MackPI/UProgrammer-Hardware/README.md

# UProgrammer-Hardware
Kicad Files for Universal programmer

Version J has updates for another spin of the PCB. 
Found errors and fixed them while checking the plots.
