MackPI/UProgrammer-Hardware/Programmer.ods

Id | Designator | Package | Quantity | Designation | Supplier and ref | Extended price @ Q5
2 | BT1 | PINHEAD1-2 | 1 | BATTERY | N/A (Will use scrap wires and Power supply)
3 | C1,C2,C12 | C_1206_HandSoldering | 3 | 1 µF | Digikey | $1.56
12 | C11,C14 | C_1206_HandSoldering | 2 | 2.2 µF 25V | Digikey | $1.53
4 | C3 | C_1206_HandSoldering | 1 | 4.7 µF | Digikey | $1.00
1 | C4,C5,C6,C7,C8,C9,C10,C13,C15,C16 | C_1206_HandSoldering | 10 | 0.1 µF | Digikey | $1.48
5 | CON1 | USB_Micro-B | 1 | USB_OTG | Digikey | $2.30
16 | D1 | MiniMELF_Handsoldering | 1 | SD103AWS | Digikey | $1.75
17 | L1 | Choke_SMD_1206_Handsoldering | 1 | 2.2 µH | Digikey | $1.90
11 | M1 | ESP-12E | 1 | ESP-12E | Banggood | $18.00 | Already purchased
18 | P1 | Measurement_Point_Square-TH_Big | 1 | Test | N/A
6 | P3 | Pin_Header_Straight_2x06 | 1 | CONN_12 | Digikey | $1.35
29 | Q1,Q3 | SOT-23 | 2 | MMBT3904 | Digikey | $0.95
30 | Q2 | SOT-23 | 1 | MMBT3906 | Digikey | $0.60
7 | R1,R2,R3,R4,R11,R12,R13 | R_1206_HandSoldering | 7 | 10K | Digikey | $0.62
24 | R14 | R_1206_HandSoldering | 1 | 100K | Digikey | $0.32 | Extra
25 | R15,R16 | R_1206_HandSoldering | 2 | 1M | Digikey | $0.24
19 | R5 | R_1206_HandSoldering | 1 | 24K | Digikey | $0.24 | Extra
20 | R6 | R_1206_HandSoldering | 1 | 47K | Digikey | $0.24
21 | R7,R10 | R_1206_HandSoldering | 2 | 4.7K | Digikey | $0.77
22 | R8 | R_1206_HandSoldering | 1 | 58.2K | Digikey | $0.32 | Extra (58.2K)
23 | R9 | R_1206_HandSoldering | 1 | 4.99K | Digikey | $0.32 | Extra
32 | REF**,REF**,REF**,REF** | MountingHole_3mm | 4 | MountingHole_3mm | N/A
14 | SW1 | SW_SPST_PTS645 | 1 | Upload | Digikey | $2.39
15 | SW2 | SW_SPST_PTS645 | 1 | RESET | ^^^ | ^^^ | Included in line above
8 | U1 | SOT-23-5 | 1 | AP2112K-3.3 | Digikey | $2.80
28 | U10 | SC-70-6_Handsoldering | 1 | NC7SB3157 | Digikey | $2.05
9 | U2 | SOIC-8_3.9x4.9mm_Pitch1.27mm | 1 | 23LC1024 | Digikey | $12.60
10 | U3,U4,U5,U6 | MSOP-8_3x3mm_Pitch0.65mm | 4 | 74LVC2T45 | Digikey | $11.50
31 | U7 | 12-TFSOJ | 1 | AAT1230 | Digikey | $3.40
26 | U8 | QFN-24-1EP_4x4mm_Pitch0.5mm | 1 | CP2104 | Digikey | $9.00
27 | U9 | SOIC-18_7.5x11.6mm_Pitch1.27mm | 1 | MCP23S08 | Digikey | $6.40
 | PCB |  |  |  | OSHPark | $60.00 | 6 PCBs
 |  |  |  |  |  | $145.63
 |  |  |  |  | Price/piece | $29.13
