MackPI/UProgrammer-Hardware/Programmer.kicad_pcb

## KiCad design Programmer.kicad_pcb (2016-11-04)

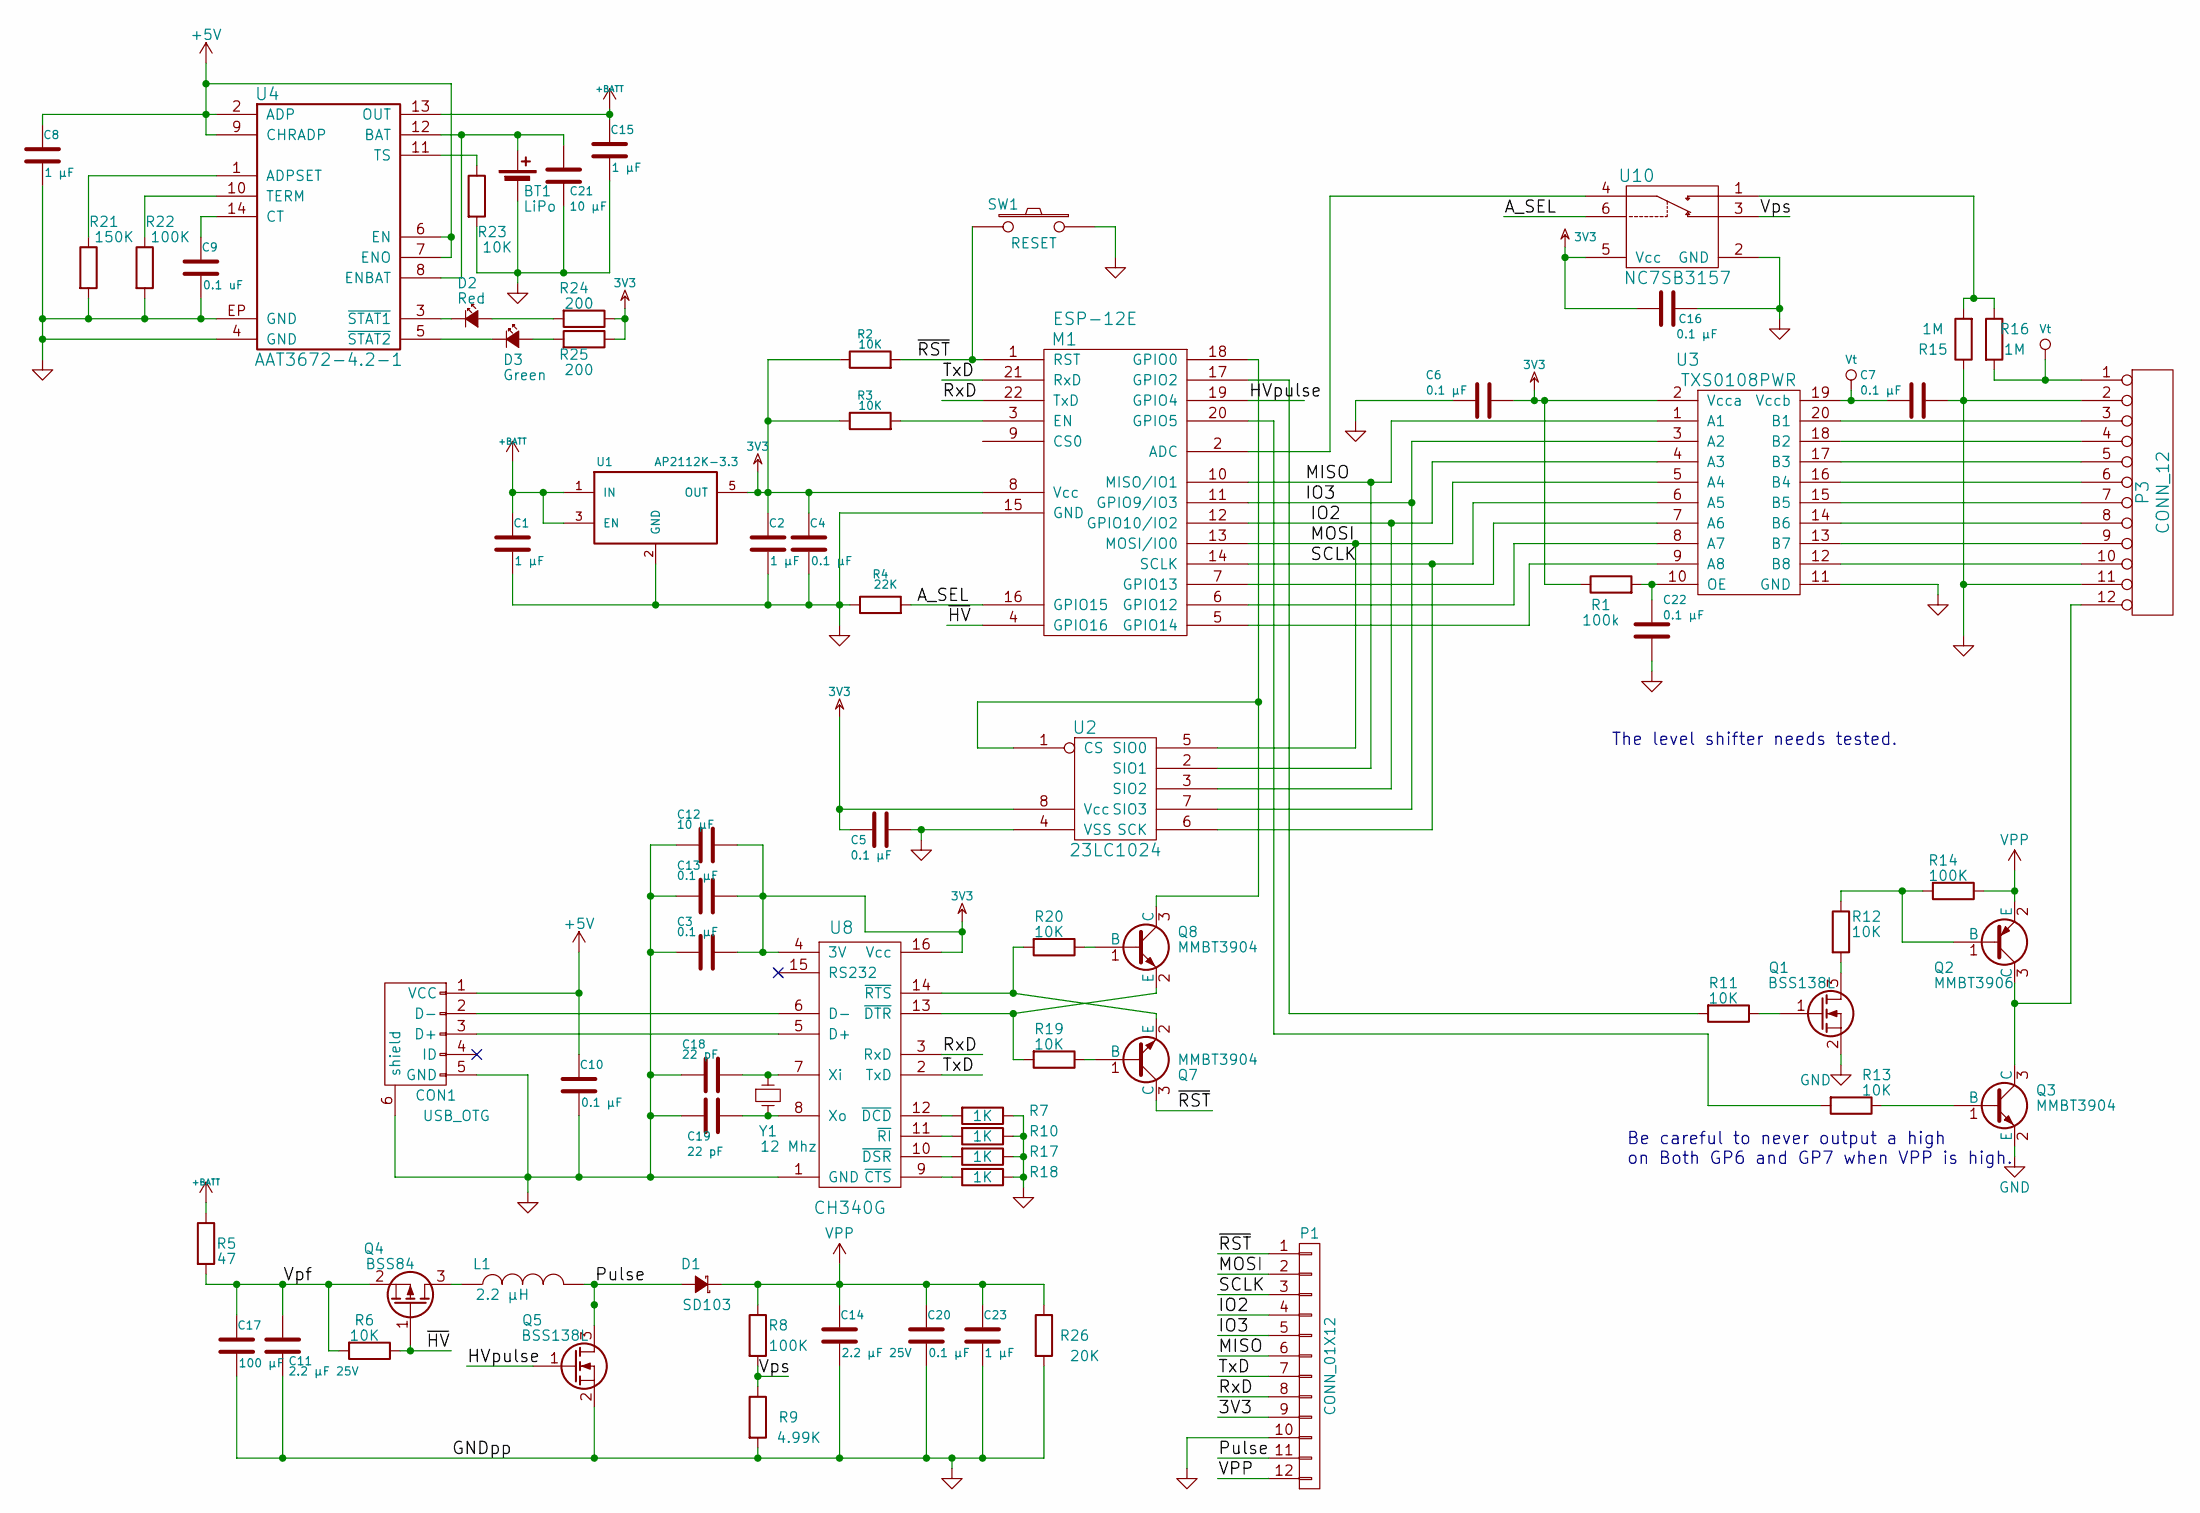
[picture p1: schematic Programmer.sch]

Parts:
BT1: LiPo; PINHEAD1-2
C1, C2, C8, C15, C23: 1 µF; C_1206
C3, C4, C5, C6, C7, C10, C13, C16, C20, C22: 0.1 µF; C_1206
C9: 0.1 uF; C_1206
C11, C14: 2.2 µF 25V; C_1206
C12, C21: 10 µF; C_1206
C17: 100 µF; C_1206
C18, C19: 22 pF; C_1206
CON1: USB_OTG; USB_Micro-B
D1: SD103; SOD-323
D2: Red; LED_1206
D3: Green; LED_1206
L1: 2.2 µH; Choke_SMD_1206_Standard
M1: ESP-12E
P1: CONN_01X12; Socket_Strip_Straight_1x12
P3: CONN_12; Pin_Header_Straight_2x06
Q1, Q5: BSS138L; SOT-23
Q2: MMBT3906; SOT-23
Q3, Q7, Q8: MMBT3904; SOT-23
Q4: BSS84; SOT-23
R1: 100k; R_1206
R2, R3, R6, R11, R12, R13, R19, R20, R23: 10K; R_1206
R4: 22K; R_1206
R5: 47; R_1206
R7, R10, R17, R18: 1K; R_1206
R8, R14, R22: 100K; R_1206
R9: 4.99K; R_1206
R15, R16: 1M; R_1206
R21: 150K; R_1206
R24, R25: 200; R_1206
R26: 20K; R_1206
SW1: RESET; R_1206
U1: AP2112K-3.3; SOT-23-5
U2: 23LC1024; SOIC-8_3.9x4.9mm_Pitch1.27mm
U3: TXS0108PWR; TSSOP-20_4.4x6.5mm_Pitch0.65mm
U4: AAT3672-4.2-1; DFN-14-1EP_3x3mm_Pitch0.4mm
U8: CH340G; SO-16-N
U10: NC7SB3157; SC-70-6
Y1: 12 Mhz; Crystal_HC49-SD_SMD; Digikey ABLS-12.000MHZ-B2-T

Connections:
3V3: C2.1, C3.1, C4.1, C5.2, C6.2, C12.1, C13.1, C16.1, M1.8 (Vcc), P1.9, R1.1, R2.1, R3.1, R24.1, R25.1, U1.5 (OUT), U2.8 (Vcc), U3.2 (Vcca), U8.4 (3V), U8.16 (Vcc), U10.5 (Vcc)
+5V: C8.1, C10.1, CON1.1 (VCC), U4.2 (ADP), U4.6 (EN), U4.7 (ENO), U4.9 (CHRADP)
+BATT: C1.1, C15.1, R5.1, U1.1 (IN), U1.3 (EN), U4.13 (OUT)
/A_SEL: M1.16 (GPIO15), R4.2, U10.6
/HVpulse: M1.19 (GPIO4), Q5.1 (G)
/IO2: M1.12 (GPIO10/IO2), P1.4, U2.3 (SIO2), U3.4 (A3)
/IO3: M1.11 (GPIO9/IO3), P1.5, U2.7 (SIO3), U3.3 (A2)
/MISO: M1.10 (MISO/IO1), P1.6, U2.2 (SIO1), U3.1 (A1)
/MOSI: M1.13 (MOSI/IO0), P1.2, U2.5 (SIO0), U3.5 (A4)
/Pulse: D1.2 (A), L1.2, P1.11, Q5.3 (D)
/RxD: M1.22 (TxD), P1.8, U8.3 (RxD)
/SCLK: M1.14 (SCLK), P1.3, U2.6 (SCK), U3.6 (A5)
/TxD: M1.21 (RxD), P1.7, U8.2 (TxD)
/Vpf: C11.1, C17.1, Q4.2 (S), R5.2, R6.2
/Vps: R8.2, R9.1, U10.3
/~HV: M1.4 (GPIO16), Q4.1 (G), R6.1
/~RST: M1.1 (RST), P1.1, Q7.3 (C), R2.2, SW1.2
GND: BT1.2, C1.2, C2.2, C3.2, C4.2, C5.1, C6.1, C7.2, C8.2, C9.2, C10.2, C11.2, C12.2, C13.2, C14.2, C15.2, C16.2, C17.2, C18.2, C19.2, C20.2, C21.2, C22.2, C23.2, CON1.5 (GND), CON1.6 (shield), M1.15 (GND), P1.10, P3.2, P3.11, Q1.2 (S), Q3.2 (E), Q5.2 (S), R4.1, R7.1, R9.2, R10.1, R15.1, R17.1, R18.1, R21.2, R22.2, R23.2, R26.2, SW1.1, U1.2 (GND), U2.4 (VSS), U3.11 (GND), U4.4 (GND), U4.EP (GND), U8.1 (GND), U10.2 (GND)
unnamed: BT1.1, C21.1, U4.8 (ENBAT), U4.12 (BAT)
unnamed: C9.1, U4.14 (CT)
unnamed: C18.1, U8.7 (Xi), Y1.1
unnamed: C19.1, U8.8 (Xo), Y1.2
unnamed: C22.1, R1.2, U3.10 (OE)
unnamed: CON1.2 (D-), U8.6 (D-)
unnamed: CON1.3 (D+), U8.5 (D+)
unnamed: D2.1 (K), U4.3 (~STAT1)
unnamed: D2.2 (A), R24.2
unnamed: D3.1 (K), U4.5 (~STAT2)
unnamed: D3.2 (A), R25.2
unnamed: L1.1, Q4.3 (D)
unnamed: M1.2 (ADC), U10.4
unnamed: M1.3 (EN), R3.2
unnamed: M1.5 (GPIO14), U3.9 (A8)
unnamed: M1.6 (GPIO12), U3.8 (A7)
unnamed: M1.7 (GPIO13), U3.7 (A6)
unnamed: M1.17 (GPIO2), R11.2
unnamed: M1.18 (GPIO0), Q8.3 (C), U2.1 (CS)
unnamed: M1.20 (GPIO5), R13.2
unnamed: P3.3, U3.20 (B1)
unnamed: P3.4, U3.18 (B2)
unnamed: P3.5, U3.17 (B3)
unnamed: P3.6, U3.16 (B4)
unnamed: P3.7, U3.15 (B5)
unnamed: P3.8, U3.14 (B6)
unnamed: P3.9, U3.13 (B7)
unnamed: P3.10, U3.12 (B8)
unnamed: P3.12, Q2.3 (C), Q3.3 (C)
unnamed: Q1.1 (G), R11.1
unnamed: Q1.3 (D), R12.2
unnamed: Q2.1 (B), R12.1, R14.2
unnamed: Q3.1 (B), R13.1
unnamed: Q7.1 (B), R19.1
unnamed: Q7.2 (E), R20.2, U8.14 (~RTS)
unnamed: Q8.1 (B), R20.1
unnamed: Q8.2 (E), R19.2, U8.13 (~DTR)
unnamed: R7.2, U8.12 (~DCD)
unnamed: R10.2, U8.11 (~RI)
unnamed: R15.2, R16.1, U10.1
unnamed: R17.2, U8.10 (~DSR)
unnamed: R18.2, U8.9 (~CTS)
unnamed: R21.1, U4.1 (ADPSET)
unnamed: R22.1, U4.10 (TERM)
unnamed: R23.1, U4.11 (TS)
VEE: C7.1, P3.1, R16.2, U3.19 (Vccb)
VPP: C14.1, C20.1, C23.1, D1.1 (K), P1.12, Q2.2 (E), R8.1, R14.1, R26.1

Notes on the sheet:
Be careful to never output a high on Both GP6 and GP7 when VPP is high.
The level shifter needs tested.

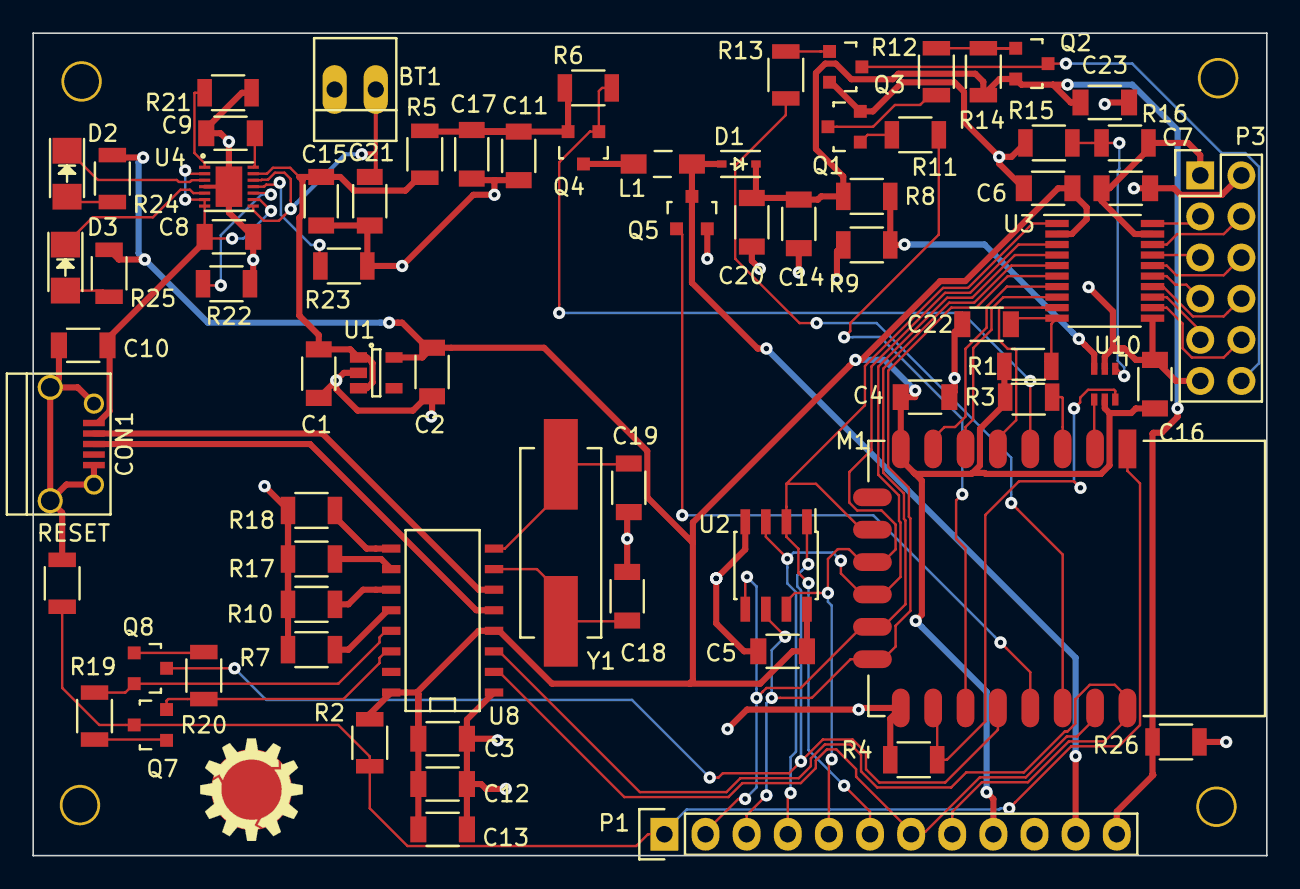
[picture p2: board Programmer.kicad_pcb from above]

Board: 2 copper layers, 76.2 x 50.8 mm, 74 parts (0 on the bottom side), 65 nets.

Other parts of the board:
Ref**: Val**; PILogo1
