MackPI/UProgrammer-Hardware/(commit log)

2015-11-06 Version 00B of Schematic
    First Published version, Has not been through engineering review.
    [Programmer.csv, Programmer.kicad_pcb, Programmer.ods, Programmer.sch]
2015-11-13 Desing Review V00B
    Corrections made from doing a Design Review.
    Now at revision 00B
    [Programmer.sch]
2015-11-20 Re-layout Update V00B
    Multiple changes to the schematic and PCB component placement, complete
    re-route of PCB.
    [Programmer.kicad_pcb, Programmer.sch]
2016-01-03 V00b PCB fixes
    Fixes needed to repair mistakes in PCB design.
    [Programmer.csv, Programmer.sch]
2016-02-12 Hardware V00C
    Design Update to start testing a lithium polimer cell as my power
    source. Added a charge management IC that charges as well as supplies
    system voltage.
    [Programmer.kicad_pcb, Programmer.sch]
2016-02-19 Hardware V00D
    Revisions found during design review
    [Programmer.sch]
2016-03-05 New Layout V00E
    Updated layout with newest schematic design.
    [Programmer.kicad_pcb, Programmer.sch]
2016-03-12 Hardware V00F
    BOM and Fabrication files
    [Programmer V00F.csv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]
2016-07-09 Hardware V00G
    Changed value of R5 from 100 to 47 Ohms. This improves the voltage boost
    functionality.
    [Programmer.kicad_pcb, Programmer.sch]
2016-09-23 Hardware Version 00H
    Schematic updated to get ready for a new layout.
    [Programmer.kicad_pcb, Programmer.sch]
2016-09-30 Small change to Voltage Boost Circuit (Hardware V00I)
    Added a loading resistor and another filter capacitor to the Voltage
    boost Circuit. R26 and C23
    [Programmer.sch]
2016-10-08 New Layout Hardware V00I
    Updated layout to match schematic in Version H. Ready to go to
    fabrication.
    [Programmer-B.Cu.gbl, Programmer-B.Mask.gbs, Programmer-Edge.Cuts.gm1, Programmer-F.Cu.gtl, Programmer-F.Fab.gbr, Programmer-F.Mask.gts, Programmer-F.SilkS.gto, Programmer-NPTH.drl]
2016-10-15 Fixed errors found Hardware V00J
    Fixed DTR/RTS Lines and my logo on the board
    [Programmer-B.Cu.gbl, Programmer-B.Mask.gbs, Programmer-B_Cu.gbl, Programmer-B_Mask.gbs, Programmer-Edge.Cuts.gm1, Programmer-Edge_Cuts.gm1, Programmer-F.Cu.gtl, Programmer-F.Fab.gbr]
2016-11-04 Minor Changes
    [Programmer.kicad_pcb]
2017-03-04 Hardware V00K
    Removed SPI RAM, Switched to HSPI only. Using FAN5331 for switching
    regulator. Some cleanup and re-labeling
    [Programmer.sch]
2017-07-23 Multiple Level shifters instead of one
    [Programmer.sch]
